germka/cdc_emu/Docs/927775-3.pdf

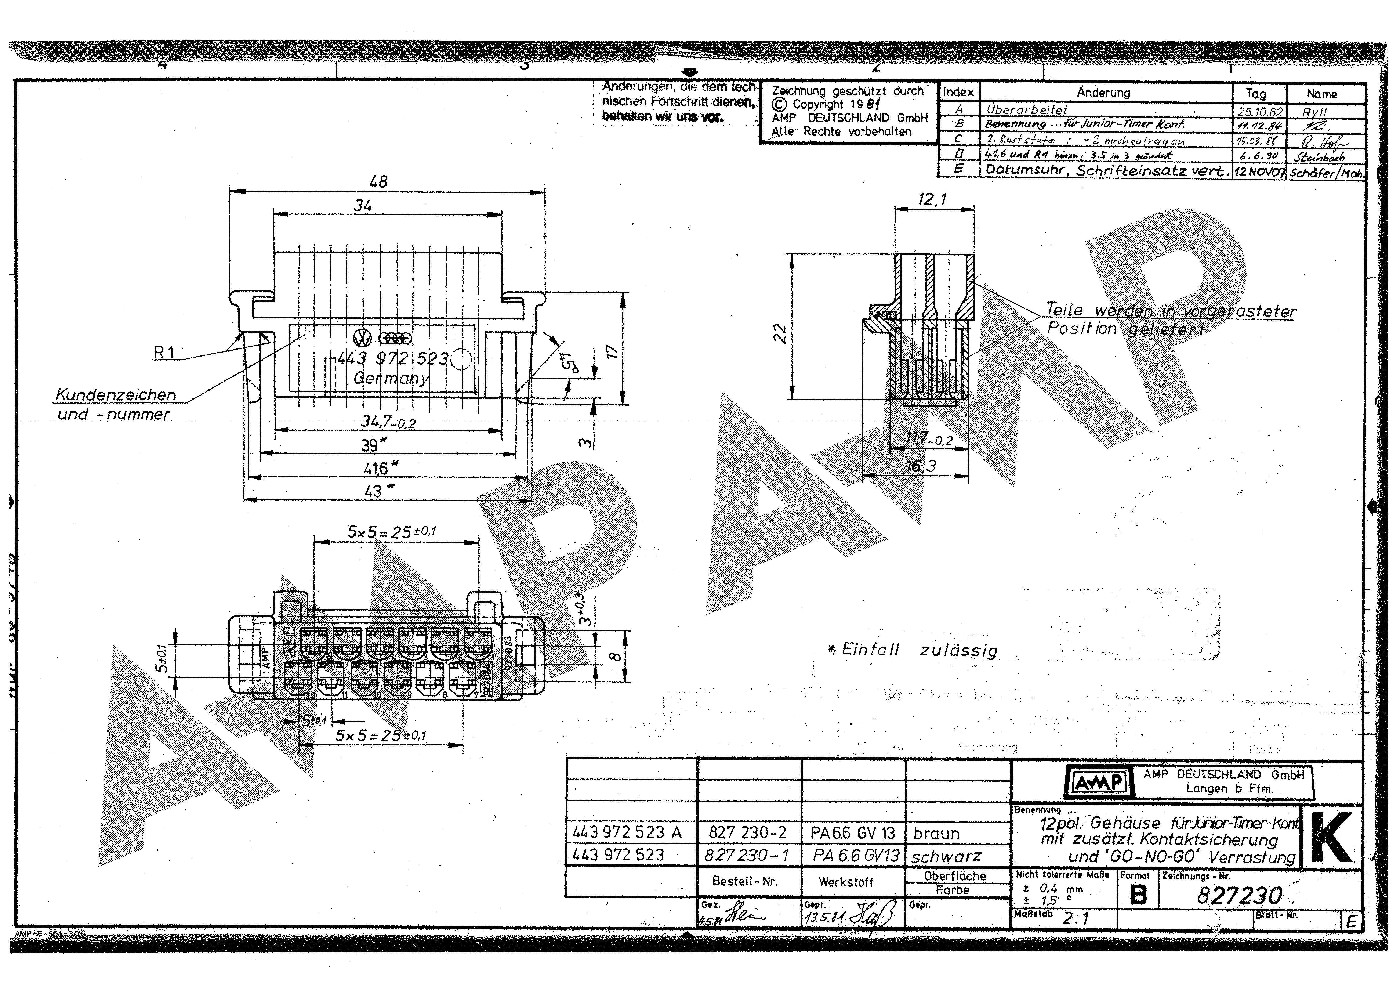
[picture p2: page 1]
