germka/cdc_emu/Docs/restyling CDC adapter.png

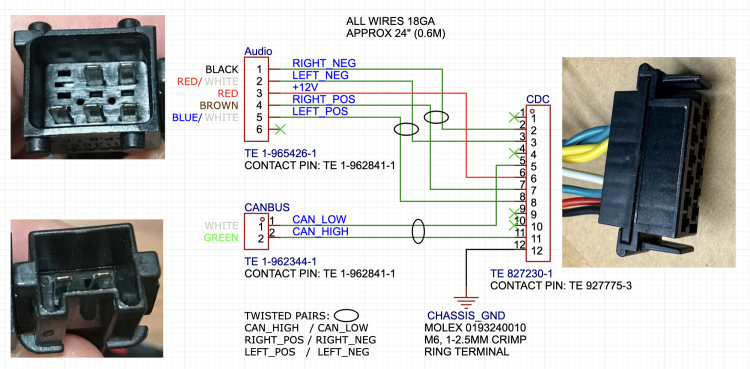
Docs/restyling CDC adapter.png
