germka/cdc_emu/Docs/SAAB 95 restyling CDC adapter.png

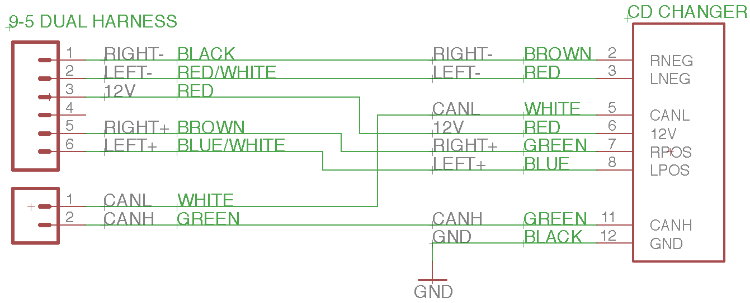
Docs/SAAB 95 restyling CDC adapter.png
