germka/cdc_emu/Pcb/BOM_Block_PCB.csv

No. | Quantity | Comment | Designator | Footprint | Value | Manufacturer Part | Manufacturer | Supplier Part | Supplier
1 | 2 | ORH-B35A | BTE,BTS | LED0805-R-RD |  | ORH-B35A | Orient | C205441 | LCSC
2 | 7 | 100nF | C1,C11,C17,C20,C21,C23,C26 | C0603 |  | GRM188R71H104KA93D | MuRata | C77055 | LCSC
3 | 2 | 22pF | C2,C3 | 0603 |  | CL10C220JB8NNNC | SAMSUNG | C1653 | LCSC
4 | 1 | 22nF | C4 | C0805 |  | CL21B223KBANNNC | SAMSUNG | C1729 | LCSC
5 | 4 | 1uF | C5,C7,C8,C9 | C0603 |  | GRM188R61E105KA12D | MuRata | C77046 | LCSC
6 | 2 | 20pF | C6,C13 | 0603 |  | 0603N200K500CT | Huaxin S&amp;T | C296052 | LCSC
7 | 4 | 10uF | C12,C19,C22,C25 | C0805 |  | CL21A106KAYNNNE | SAMSUNG | C15850 | LCSC
8 | 2 | 100nF | C14,C15 | 0805 |  | CGA4J2X7R2A104KT0Y0U | TDK | C342919 | LCSC
9 | 1 | 15pF | C16 | 0603 |  | CL10C150JB8NNNC | SAMSUNG | C1644 | LCSC
10 | 1 | 4.7uF | C18 | 0603 |  | GRM188R60J475KE19D | MuRata | C71631 | LCSC
11 | 2 | 22uF | C24,C28 | 0805 |  | CL21X226MQQNNNE | Samsung Electro-Mechanics | C307562 | LCSC
12 | 1 | 1uF | C27 | C0603 |  | CL10A105KB8NNNC | SAMSUNG | C15849 | LCSC
13 | 1 | 10pF | C29 | C0603 |  | TCC0603COG100J500CT | CCTC | C376764 | LCSC
14 | 2 | ORH-G35A | CRX,CTX | LED0805-R-RD |  | ORH-G35A | Orient | C205442 | LCSC
15 | 1 | PESD1CAN_C284094 | D1 | SOT-23-3_L2.9-W1.3-P1.90-LS2.4-BR |  | PESD1CAN | DOWO | C284094 | LCSC
16 | 2 | LXES15AAA1-153 | E1,E2 | D0402-BI |  | LXES15AAA1-153 | MuRata | C86141 | LCSC
17 | 1 | LED-Red | ERR | LED-0805 |  | 17-21SURC/S530-A2/TR8 | Everlight Elec | C131244 | LCSC
18 | 1 | 15nH | L2 | L0603 |  | SDCL1608C15NJTDF | Sunlord | C23651 | LCSC
19 | 1 | SPM4015T-4R7M-LR | L3 | IND-SMD_L4.4-W4.1 |  | SPM4015T-4R7M-LR | TDK | C2052599 | LCSC
20 | 2 | AD8131ARMZ-REEL7 | LC-AMP,RC-AMP | MSOP-8_L3.0-W3.0-P0.65-LS4.9-BL |  | AD8131ARMZ-REEL7 | Analog Devices | C495043 | LCSC
21 | 1 | STM32F103CBU6 | MCU | UFQFPN-48_49PIN-L7.10-W7.10-PITCH0.50-EP5.6-TL |  | STM32F103CBU6 | ST | C55506 | LCSC
22 | 1 | ORH-YG35A | PWR>ON | LED0805-R-RD |  | ORH-YG35A | Orient | C205449 | LCSC
23 | 12 | 1.5K | R1,R2,R4,R5,R6,R8,R13,R14,R15,R17,R26,R30 | 0603 |  | 0603WAF1501T5E | UniOhm | C22843 | LCSC
24 | 1 | 100K | R3 | 0603 |  | CR0603-FX-1003ELF | BOURNS | C203223 | LCSC
25 | 1 | 10kΩ | R7 | R0603 |  | PTFR0603D10K0P9 | ResistorToday | C375971 | LCSC
26 | 1 | 10Ω | R9 | R0603 |  | TR0603D10RP0510 | Ever Ohms Tech | C153363 | LCSC
27 | 1 | 24.3kΩ | R10 | R0603 |  | 0603WAF2432T5E | UniOhm | C23348 | LCSC
28 | 1 | 0 | R11 | R0402 |  | CR-02JL6----0R | Viking Tech | C279984 | LCSC
29 | 1 | 2.2K | R12 | 0603 |  | 0603WAF2201T5E | UniOhm | C4190 | LCSC
30 | 1 | 220 | R16 | 0603 |  | AR03FTC2200 | Viking Tech | C234383 | LCSC
31 | 2 | 100K | R18,R32 | 0603 |  | ERJPB3D1003V | PANASONIC | C189496 | LCSC
32 | 1 | 1.2kΩ | R19 | R0603 |  | RMC06031.2K1%N | Tyohm | C325597 | LCSC
33 | 1 | 1K | R20 | R0603 |  | 0603WAD1001T5E | UniOhm | C51218 | LCSC
34 | 2 | 7.68kΩ | R21,R24 | R0603 |  | RMS06FT7681 | TA-I Tech | C209197 | LCSC
35 | 1 | 25kΩ | R22 | R0603 |  | AR03BTCX2502 | 光颉(Viking) | C2828637 | LCSC
36 | 1 | 40.2kΩ | R23 | R0603 |  | ERJ3EKF4022V | PANASONIC | C403206 | LCSC
37 | 1 | 200kΩ | R33 | R0603 | 200kΩ | 0603WAF2003T5E | UNI-ROYAL(厚声) | C25811 | LCSC
38 | 4 | 10K | R34,R35,R36,R37 | R0603 | 10K
39 | 1 | TS-1002S-08026C | RESET | SW-SMD_4P-L6.0-W6.0-P4.50-LS9.0-2 |  | TS-1002S-08026C | XUNPU(讯普) | C455116 | LCSC
40 | 1 | 100 | RN1 | RES-ARRAY-SMD_0603-8P-L3.2-W1.6-BL |  | YC164-FR-07100RL | YAGEO | C136838 | LCSC
41 | 1 | 330 | RN2 | RES-ARRAY-SMD_0603-8P-L3.2-W1.6-BL |  | 4D03WGJ0331T5E | UniOhm | C12018 | LCSC
42 | 1 | 1K | RN3 | RES-ARRAY-SMD_0603-8P-L3.2-W1.6-BL |  | YC164-FR-071KL | YAGEO | C110021 | LCSC
43 | 1 | RT9043GB | U1 | SOT-23-5_L3.0-W1.7-P0.95-LS2.8-BR |  | RT9043GB | RICHTEK | C55019 | LCSC
44 | 1 | SN65HVD230DR | U3 | SOIC-8_L4.9-W3.9-P1.27-LS6.0-BL |  | SN65HVD230DR | TI | C12084 | LCSC
45 | 1 | MP1658GTF | U4 | SOT-563-6_L1.6-W1.2-P0.5-LS1.6-BL |  | MP1658GTF | null | C9900003030 | LCSC
46 | 1 | RT9193-33GB | U5 | SOT-23-5_L3.0-W1.7-P0.95-LS2.8-BR |  | RT9193-33GB | RICHTEK | C15651 | LCSC
47 | 1 | 1N5819W | U6 | SOD-123_L2.7-W1.6-LS3.7-FD |  | 1N5819W | HXY MOSFET(华轩阳电子) | C5451628 | LCSC
48 | 1 | 8MHz | X1 | OSC-SMD_2P-L5.0-W3.2 |  | 6I08000F20UCG | SHENZHEN CRYSTAL TECH | C251585 | LCSC
