germka/cdc_emu/Pcb/PCB_PCB.pdf

# A0 A1 A2 GND

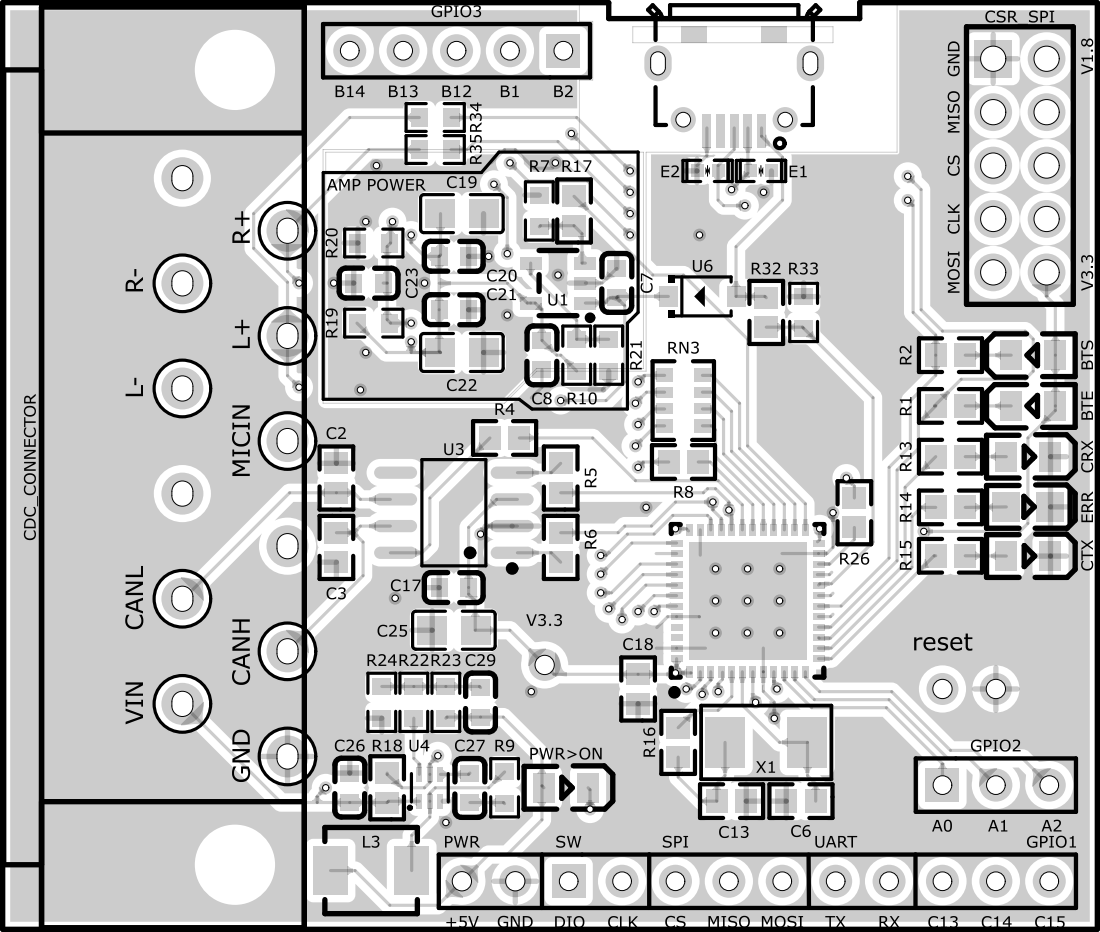
[picture p5: page 1]

GPIO3

DIO CLK CS MISOMOSI TX RX C13 C14 C15 CS MISO MOSI CLK

CTX ERR BTE BTS CRX

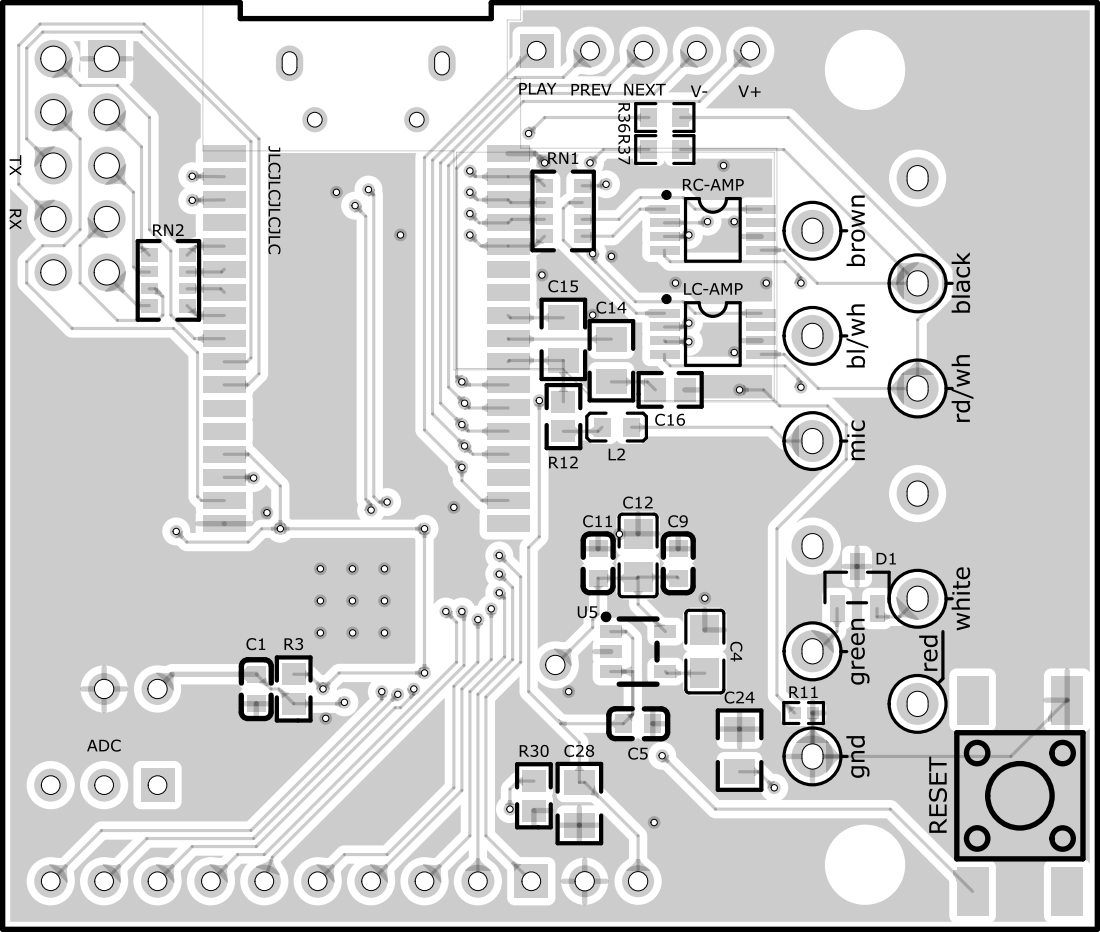
[picture p6: page 2]

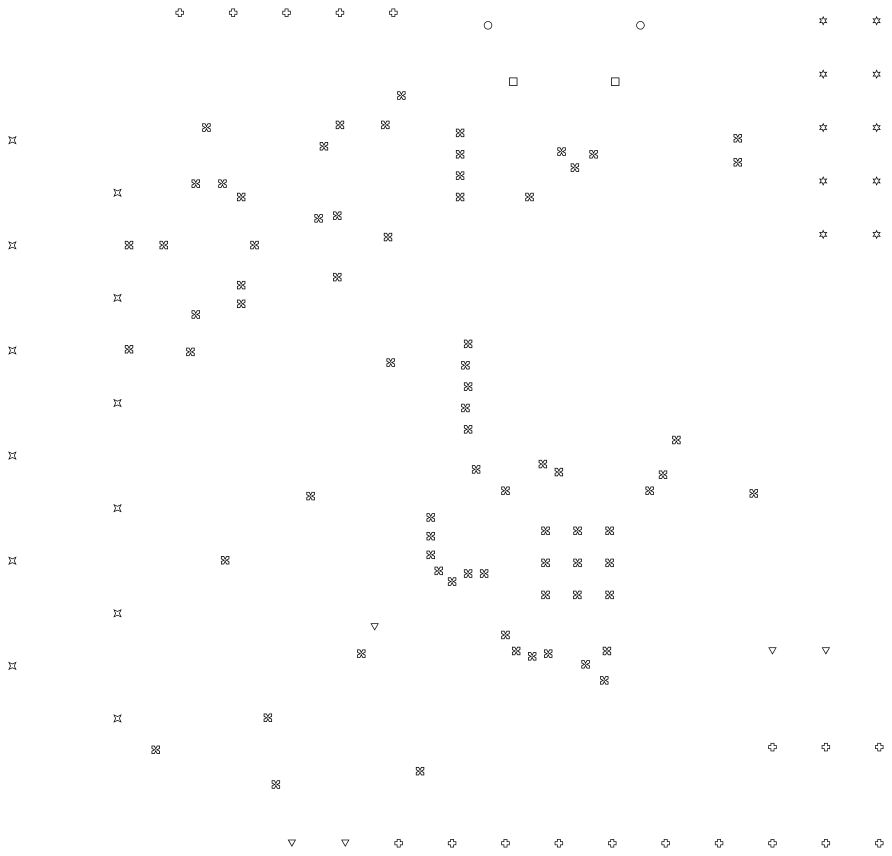
[picture p7: page 3]
