germka/cdc_emu/Core/Inc/main.h

#define LEDTX_Pin GPIO_PIN_3
#define LEDTX_GPIO_Port GPIOA
#define LEDERR_Pin GPIO_PIN_4
#define LEDERR_GPIO_Port GPIOA
#define LEDRX_Pin GPIO_PIN_5
#define LEDRX_GPIO_Port GPIOA
#define LED1_Pin GPIO_PIN_6
#define LED1_GPIO_Port GPIOA
#define LED0_Pin GPIO_PIN_0
#define LED0_GPIO_Port GPIOB
#define BTEN_Pin GPIO_PIN_11
#define BTEN_GPIO_Port GPIOB
#define AMPEN_Pin GPIO_PIN_12
#define AMPEN_GPIO_Port GPIOB
#define VOL__Pin GPIO_PIN_13
#define VOL__GPIO_Port GPIOB
#define VOL_B14_Pin GPIO_PIN_14
#define VOL_B14_GPIO_Port GPIOB
#define NEXT_Pin GPIO_PIN_15
#define NEXT_GPIO_Port GPIOB
#define PREV_Pin GPIO_PIN_8
#define PREV_GPIO_Port GPIOA
#define PLAY_Pin GPIO_PIN_9
#define PLAY_GPIO_Port GPIOA
#define CANRS_Pin GPIO_PIN_10
#define CANRS_GPIO_Port GPIOA
