germka/cdc_emu/(commit log)

2024-02-27 feat: Events indication task && CAN bus initialization
2024-02-28 feat: CAN bus data routing by header
2024-03-04 feat: can sender task prototype
2024-03-05 feat: uart debug method
2024-03-05 feat: Debug build uart logging gcc directive
2024-03-07 fix: systick save before sleep & AMP power handle
    [bluetooth.c]
2024-03-08 feat: power save based on RTOS functional
2024-04-11 fix: disabled system TICKLESS_IDLE, change AMP pin, can offline mode, power ctl on queue
    [bluetooth.c, can.c, cdc_emu_3.0.ioc, main.h, usart.c]
2024-04-12 fix: CAN enable ABOM,AWUM,TXFP, continious status check
    [can.c, cdc_emu_3.0.ioc]
2024-04-13 fix: flood on CAN online
    [CDC.h]
2024-05-13 feat: reverse gear low sound level
2024-05-14 fix: pedals event only on R gear, refactor
    [CDC.h, bluetooth.c, can.c]
2024-05-15 feat: automatic gearbox canbus messages reading
2024-05-16 fix: gear and shift event updates, sound messages queue
    [bluetooth.c, bluetooth.h, can.c]
2024-05-16 docs: production documentation
    [BOM_Block_PCB.csv, PickAndPlace_PCB.csv]
2024-05-24 fix: sound message type select
    [bluetooth.c, can.c]
2024-06-05 feat: cdc power status event message
2024-07-18 fix: PCB USB design, remove unused GPIO pin
    [cdc_emu_3.0.ioc, main.h]
