germka/cdc_emu/(notices)

Notices in the files:
Core/Src/usart.c:
Copyright (c) 2024 STMicroelectronics.
All rights reserved.
This software is licensed under terms that can be found in the LICENSE file
Core/Src/can.c:
Copyright (c) 2023 STMicroelectronics.
